AryanBL/SmartSafe/SmartSafe_Servo_Keypad_Tamper_Documents/SmartSafe_Servo_Keypad_Tamper_Documents/README.txt

SmartSafe technical module reports

1. SmartSafe_Servo_Module_Report
   - Timer1 Fast PWM mode 14
   - 50 Hz and 20 ms frame calculations
   - ICR1, OCR1A, prescaler, angle mapping
   - Timer2 five-second open interval

2. SmartSafe_Keypad_Module_Report
   - 4 x 4 matrix operation
   - GPIO registers, internal pull-ups, row scanning
   - Pin mapping, key map, settling and debounce
   - Main-loop integration

3. SmartSafe_Tamper_ADC_Module_Report
   - ADC3 wiring and register configuration
   - ADC clock, resolution and threshold calculations
   - Timer2 periodic sampling
   - Stable-reference tamper algorithm
   - USART 9600-baud calculation and event workflow
