AryanBL/SmartSafe/(list of files, drawings)

Other design files:
SmartSafe.pdsprj
